whitecatboard/whitecat-hardware/ESP32N1 DEVKIT/Kicad/production/preview.png

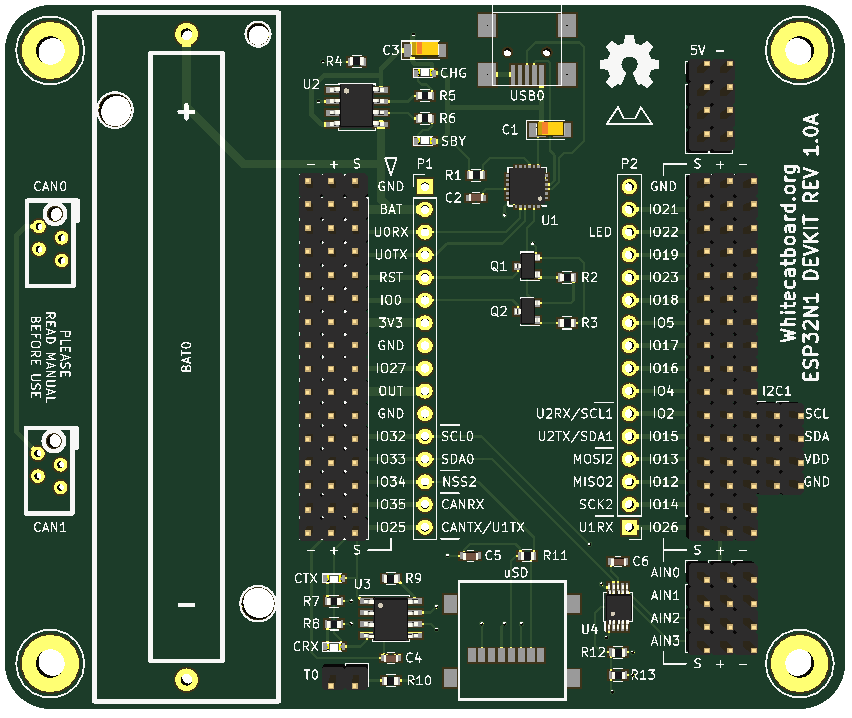
ESP32N1 DEVKIT/Kicad/production/preview.png
