whitecatboard/whitecat-hardware/ESP32N1/Kicad/ESP32N1.pdf

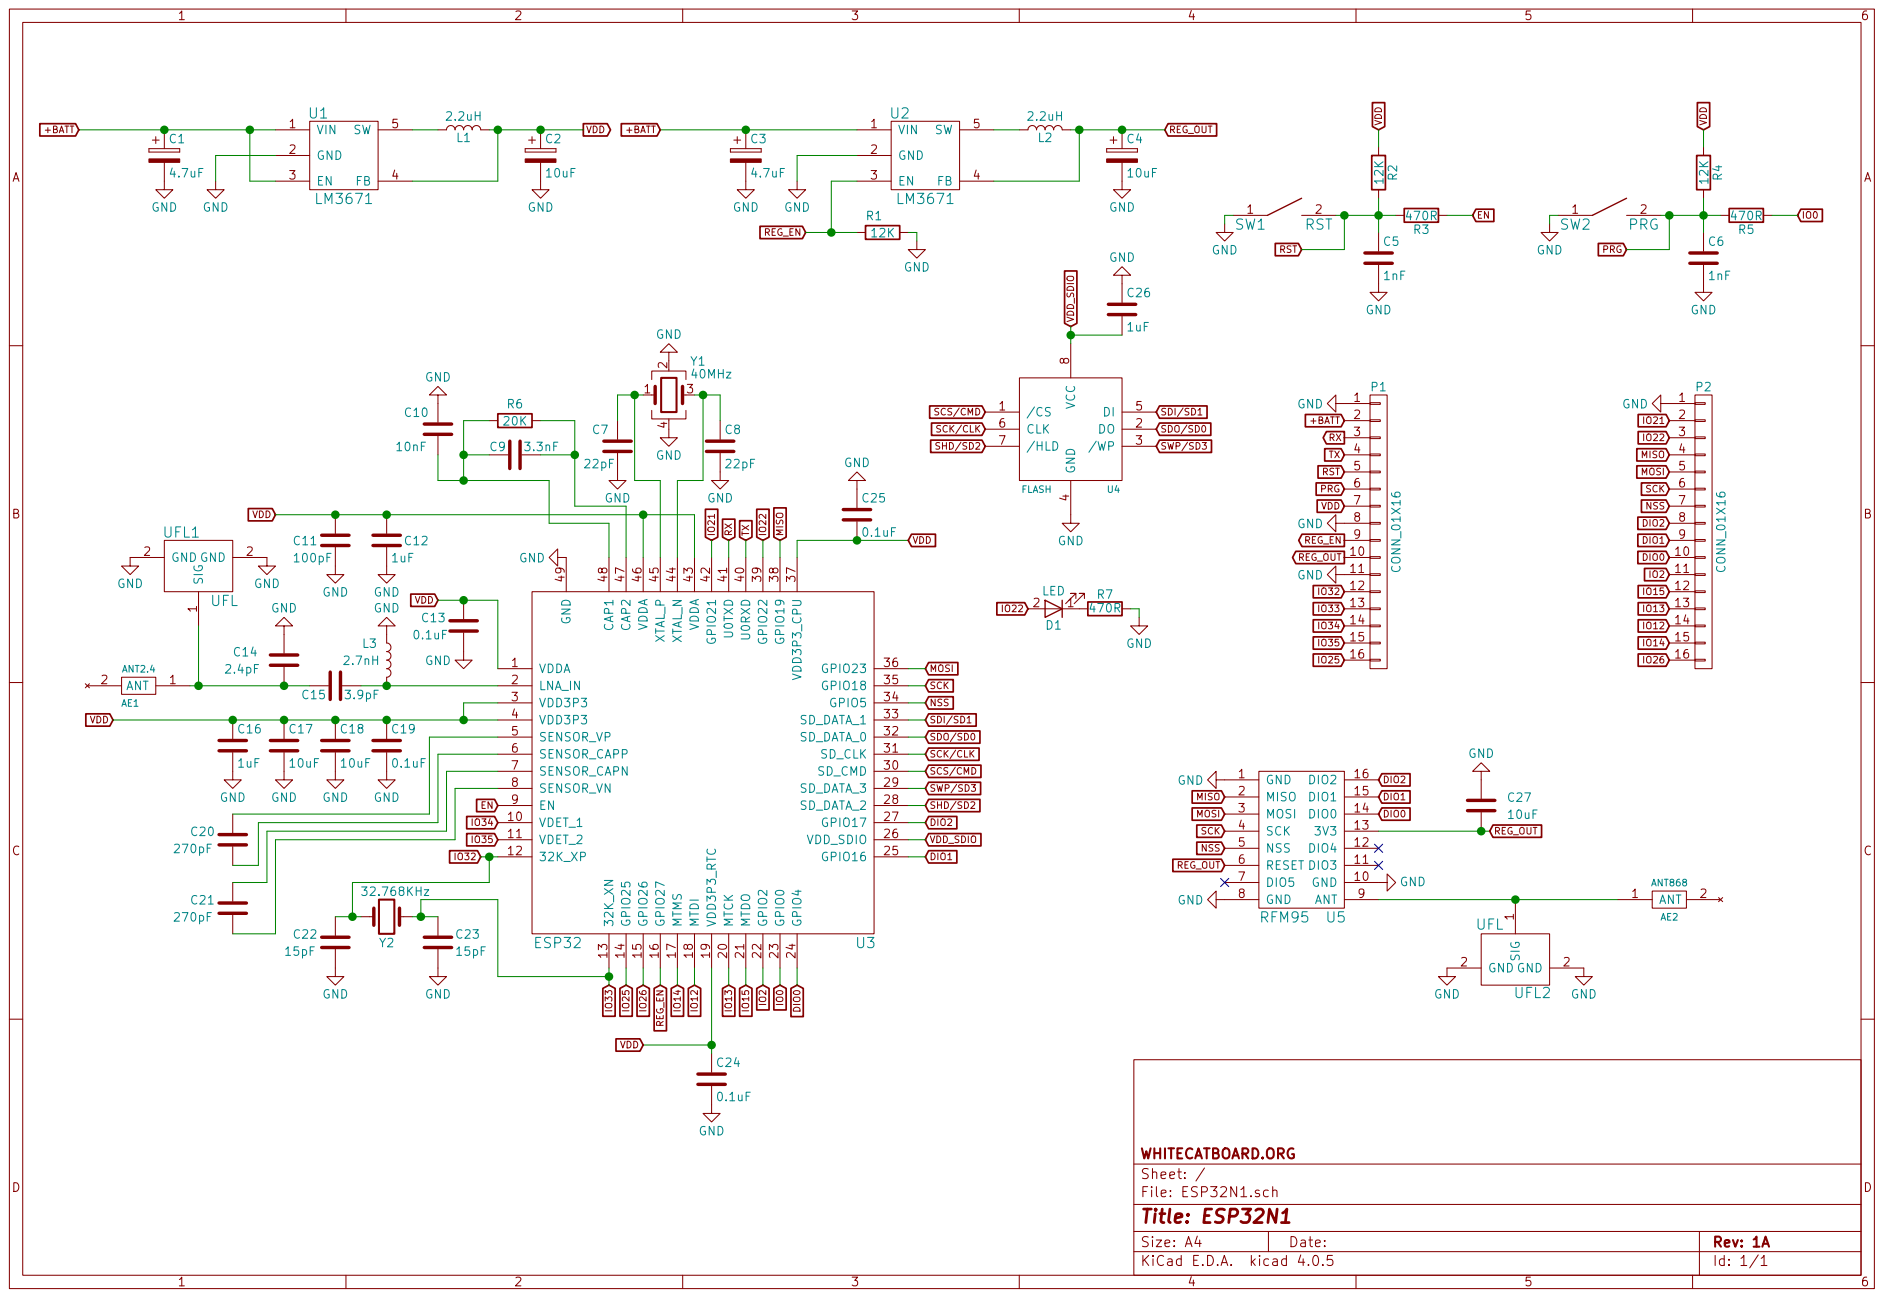
[picture p2: page 1]

IO2 DIO0 DIO1 DIO2 SHD/SD2 SWP/SD3 SCS/CMD

1 GND 2 GND 2 UFL1 UFL GND GND

1 GND 2 GND 2 UFL2 UFL GND GND

File: ESP32N1.sch Sheet: / WHITECATBOARD.ORG
