whitecatboard/whitecat-hardware/ESP32N1/Kicad/ESP32N1.kicad_pcb

## KiCad design ESP32N1/Kicad/ESP32N1.kicad_pcb (2017-11-29)

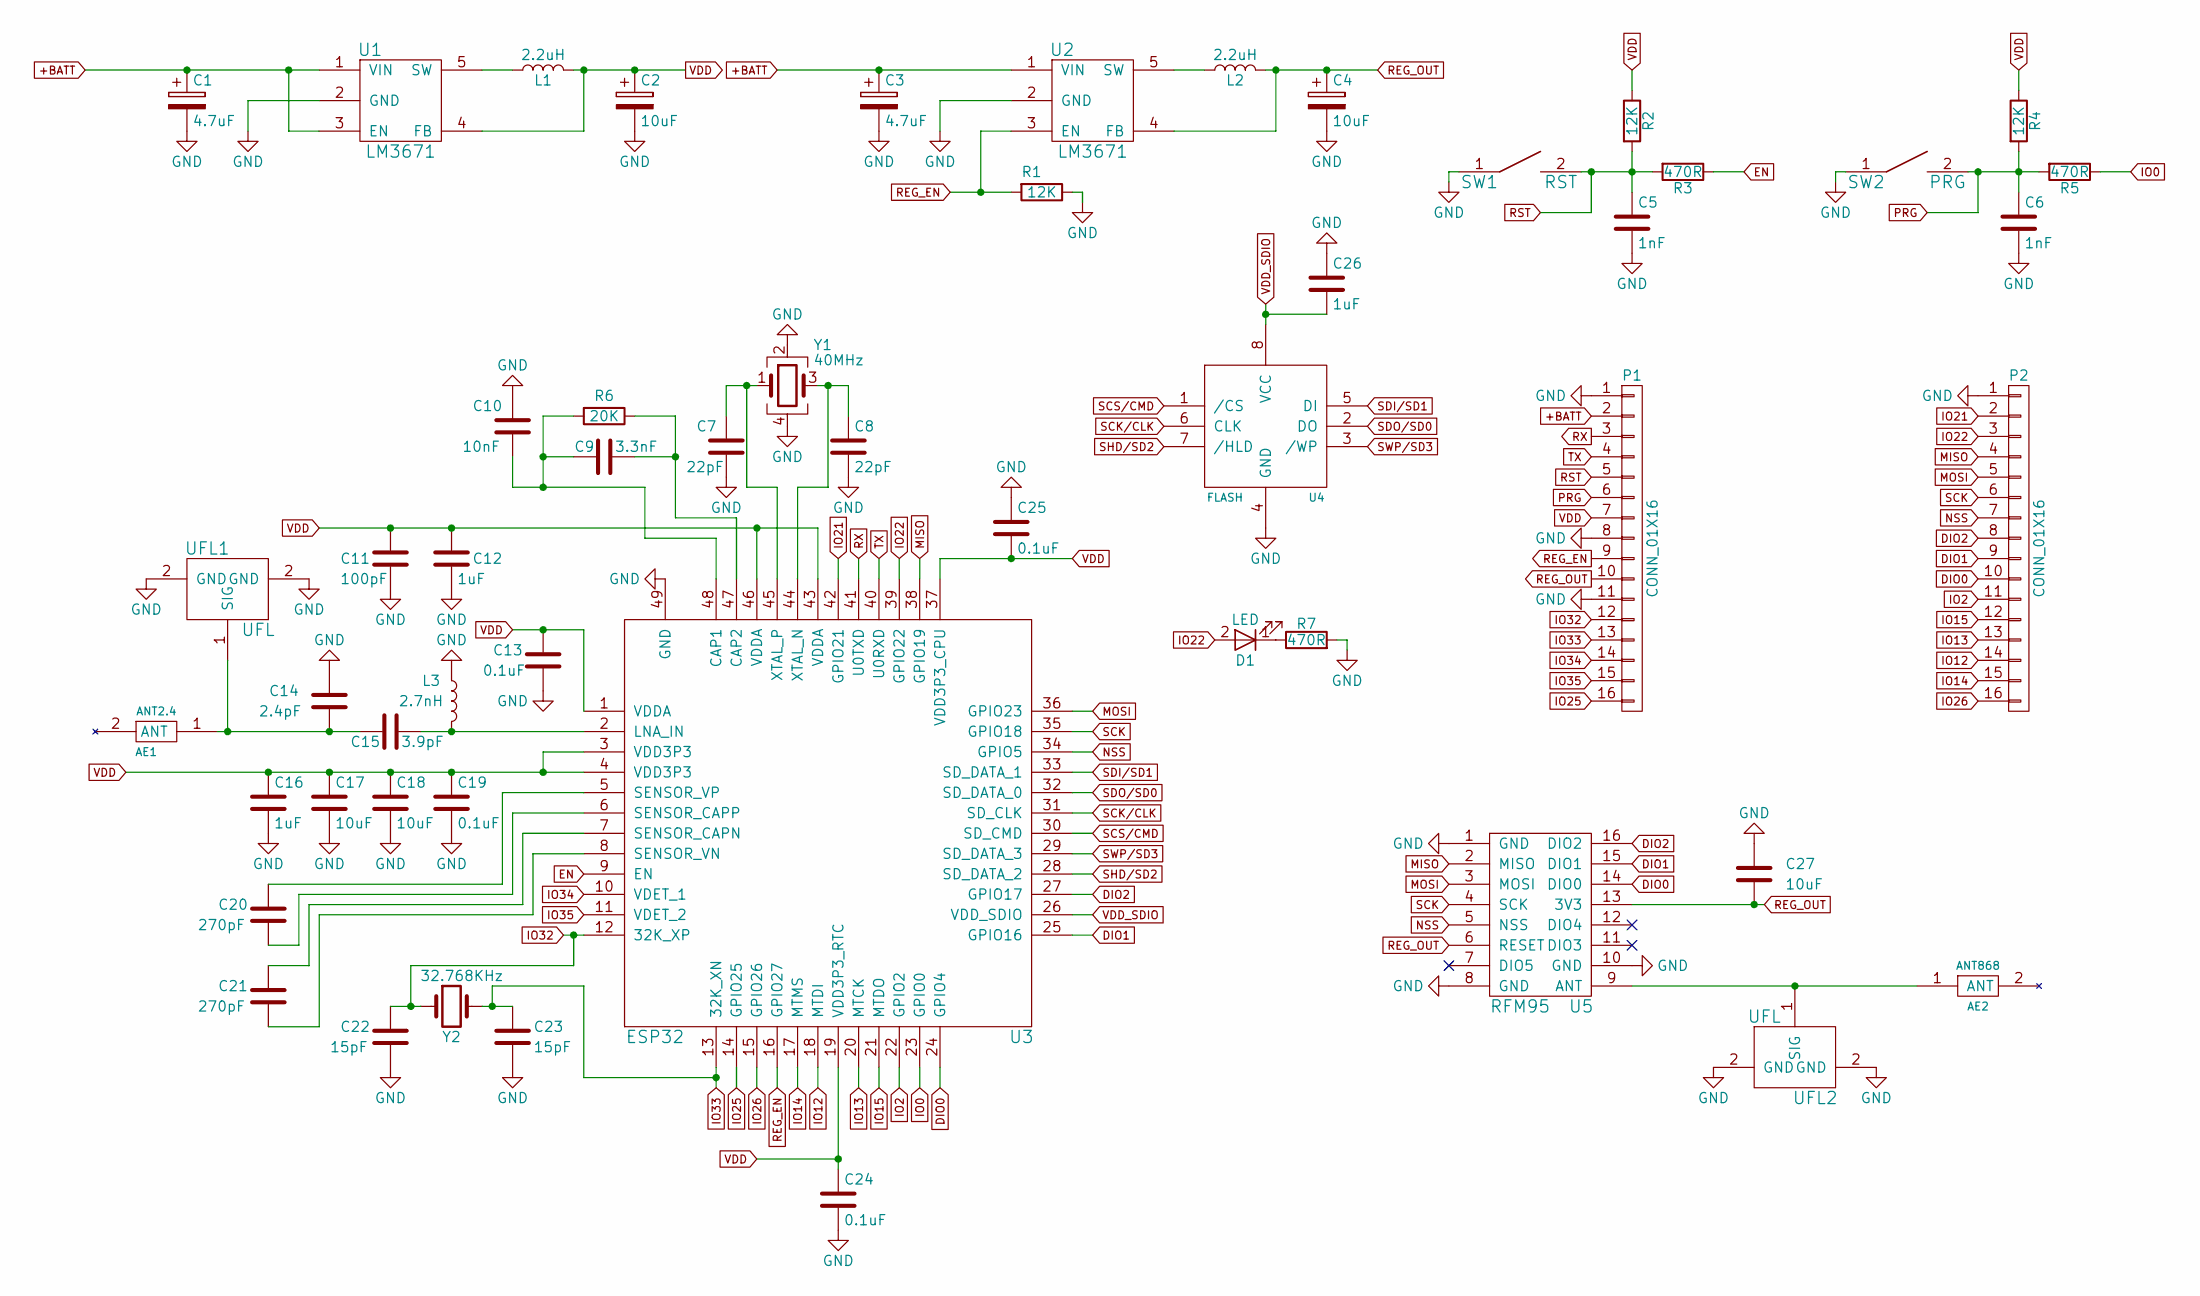
[picture p3: schematic ESP32N1.sch]

Parts:
AE1: ANT2.4
AE2: ANT868
C1, C3: 4.7uF; CP_Tantalum_Case-A_EIA-3216-18_Reflow
C2, C4: 10uF; CP_Tantalum_Case-A_EIA-3216-18_Reflow
C5, C6: 1nF; C_0603
C7, C8: 22pF; C_0603
C9: 3.3nF; C_0603
C10: 10nF; C_0603
C11: 100pF; C_0603
C12, C16, C26: 1uF; C_0603
C13, C19, C24, C25: 0.1uF; C_0603
C14: 2.4pF; C_0603
C15: 3.9pF; C_0603
C17, C18, C27: 10uF; C_0603
C20, C21: 270pF; C_0603
C22, C23: 15pF; C_0603
D1: LED; LED_0603
L1, L2: 2.2uH; R_0603
L3: 2.7nH; R_0603
P1, P2: CONN_01X16; Pin_Header_Straight_1x16_Pitch2.54mm
R1, R2, R4: 12K; R_0603
R3, R5, R7: 470R; R_0603
R6: 20K; R_0603
SW1: RST; PTS820
SW2: PRG; PTS820
U1, U2: LM3671; SOT-23-5
U3: ESP32; UQFN-48-1EP_6x6mm_Pitch0.4mm
U4: FLASH; SOIC-8-208
U5: RFM95; RFM95W
UFL1, UFL2: UFL; COAXIAL_U.FL-R-SMT-1
Y1: 40MHz; Crystal_SMD_TXC_7M-4pin_3.2x2.5mm
Y2: 32.768KHz; Crystal_SMD_MicroCrystal_CC7V-T1A-2pin_3.2x1.5mm

Connections:
+BATT: C1.1, C3.1, P1.2, U1.1 (VIN), U1.3 (EN), U2.1 (VIN)
DIO0: P2.10, U3.24 (GPIO4), U5.14 (DIO0)
DIO1: P2.9, U3.25 (GPIO16), U5.15 (DIO1)
DIO2: P2.8, U3.27 (GPIO17), U5.16 (DIO2)
EN: R3.1, U3.9 (EN)
GND: C1.2, C2.2, C3.2, C4.2, C5.2, C6.2, C7.2, C8.2, C10.1, C11.2, C12.2, C13.2, C14.1, C16.2, C17.2, C18.2, C19.2, C22.2, C23.2, C24.2, C25.1, C26.1, C27.1, L3.1, P1.1, P1.8, P1.11, P2.1, R1.1, R7.2, SW1.1, SW2.1, U1.2 (GND), U2.2 (GND), U3.49 (GND), U4.4 (GND), U5.1 (GND), U5.8 (GND), U5.10 (GND), UFL1.2 (GND), UFL2.2 (GND), Y1.2, Y1.4
IO0: R5.1, U3.23 (GPIO0)
IO2: P2.11, U3.22 (GPIO2)
IO12: P2.14, U3.18 (MTDI)
IO13: P2.13, U3.20 (MTCK)
IO14: P2.15, U3.17 (MTMS)
IO15: P2.12, U3.21 (MTDO)
IO21: P2.2, U3.42 (GPIO21)
IO22: D1.2 (A), P2.3, U3.39 (GPIO22)
IO25: P1.16, U3.14 (GPIO25)
IO26: P2.16, U3.15 (GPIO26)
IO32: C22.1, P1.12, U3.12 (32K_XP), Y2.1
IO33: C23.1, P1.13, U3.13 (32K_XN), Y2.2
IO34: P1.14, U3.10 (VDET_1)
IO35: P1.15, U3.11 (VDET_2)
MISO: P2.4, U3.38 (GPIO19), U5.2 (MISO)
MOSI: P2.5, U3.36 (GPIO23), U5.3 (MOSI)
NSS: P2.7, U3.34 (GPIO5), U5.5 (NSS)
unnamed: AE1.1 (ANT), C14.2, C15.2, UFL1.1 (SIG)
unnamed: AE2.1 (ANT), U5.9 (ANT), UFL2.1 (SIG)
unnamed: C7.1, U3.45 (XTAL_P), Y1.1
unnamed: C8.1, U3.44 (XTAL_N), Y1.3
unnamed: C9.1, R6.1, U3.47 (CAP2)
unnamed: C9.2, C10.2, R6.2, U3.48 (CAP1)
unnamed: C15.1, L3.2, U3.2 (LNA_IN)
unnamed: C20.1, U3.5 (SENSOR_VP)
unnamed: C20.2, U3.6 (SENSOR_CAPP)
unnamed: C21.1, U3.7 (SENSOR_CAPN)
unnamed: C21.2, U3.8 (SENSOR_VN)
unnamed: D1.1 (K), R7.1
unnamed: L1.1, U1.5 (SW)
unnamed: L2.1, U2.5 (SW)
PRG: C6.1, P1.6, R4.2, R5.2, SW2.2
REG_EN: P1.9, R1.2, U2.3 (EN), U3.16 (GPIO27)
REG_OUT: C4.1, C27.2, L2.2, P1.10, U2.4 (FB), U5.6 (RESET), U5.13 (3V3)
RST: C5.1, P1.5, R2.2, R3.2, SW1.2
RX: P1.3, U3.41 (U0TXD)
SCK: P2.6, U3.35 (GPIO18), U5.4 (SCK)
SCK/CLK: U3.31 (SD_CLK), U4.6 (CLK)
SCS/CMD: U3.30 (SD_CMD), U4.1 (/CS)
SDI/SD1: U3.33 (SD_DATA_1), U4.5 (DI)
SDO/SD0: U3.32 (SD_DATA_0), U4.2 (DO)
SHD/SD2: U3.28 (SD_DATA_2), U4.7 (/HLD)
SWP/SD3: U3.29 (SD_DATA_3), U4.3 (/WP)
TX: P1.4, U3.40 (U0RXD)
VDD: C2.1, C11.1, C12.1, C13.1, C16.1, C17.1, C18.1, C19.1, C24.1, C25.2, L1.2, P1.7, R2.1, R4.1, U1.4 (FB), U3.1 (VDDA), U3.3 (VDD3P3), U3.4 (VDD3P3), U3.19 (VDD3P3_RTC), U3.37 (VDD3P3_CPU), U3.43 (VDDA), U3.46 (VDDA)
VDD_SDIO: C26.2, U3.26 (VDD_SDIO), U4.8 (VCC)

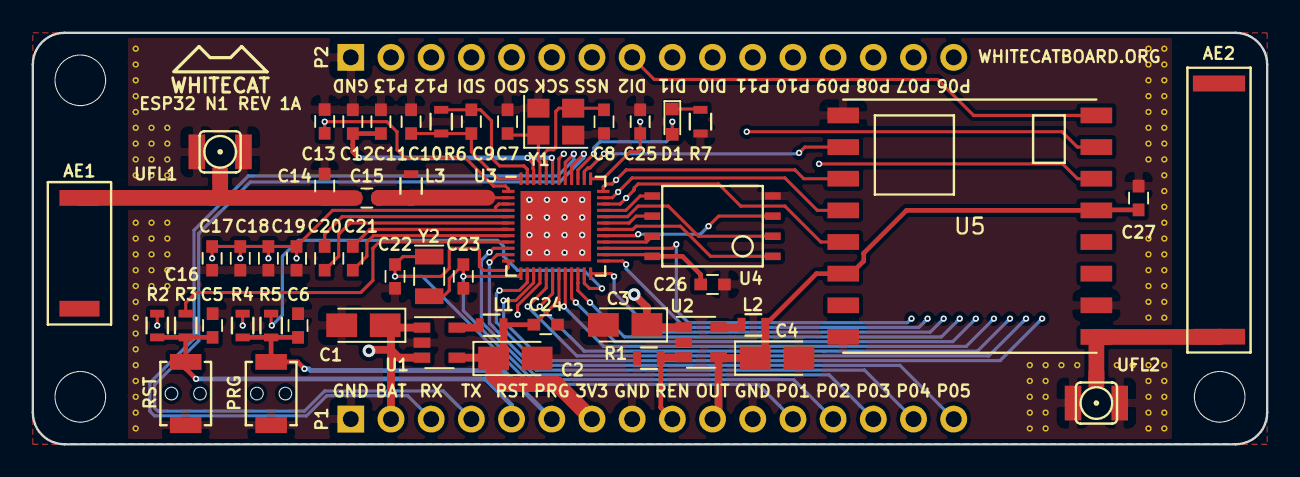
[picture p4: board ESP32N1.kicad_pcb from above]

Board: 4 copper layers, 78.0 x 26.0 mm, 53 parts (0 on the bottom side), 52 nets.
