whitecatboard/whitecat-hardware/ESP32N1 DEVKIT/Kicad/ESP32N1DEVKIT.kicad_pcb

## KiCad design ESP32N1 DEVKIT/Kicad/ESP32N1DEVKIT.kicad_pcb (2017-11-29)

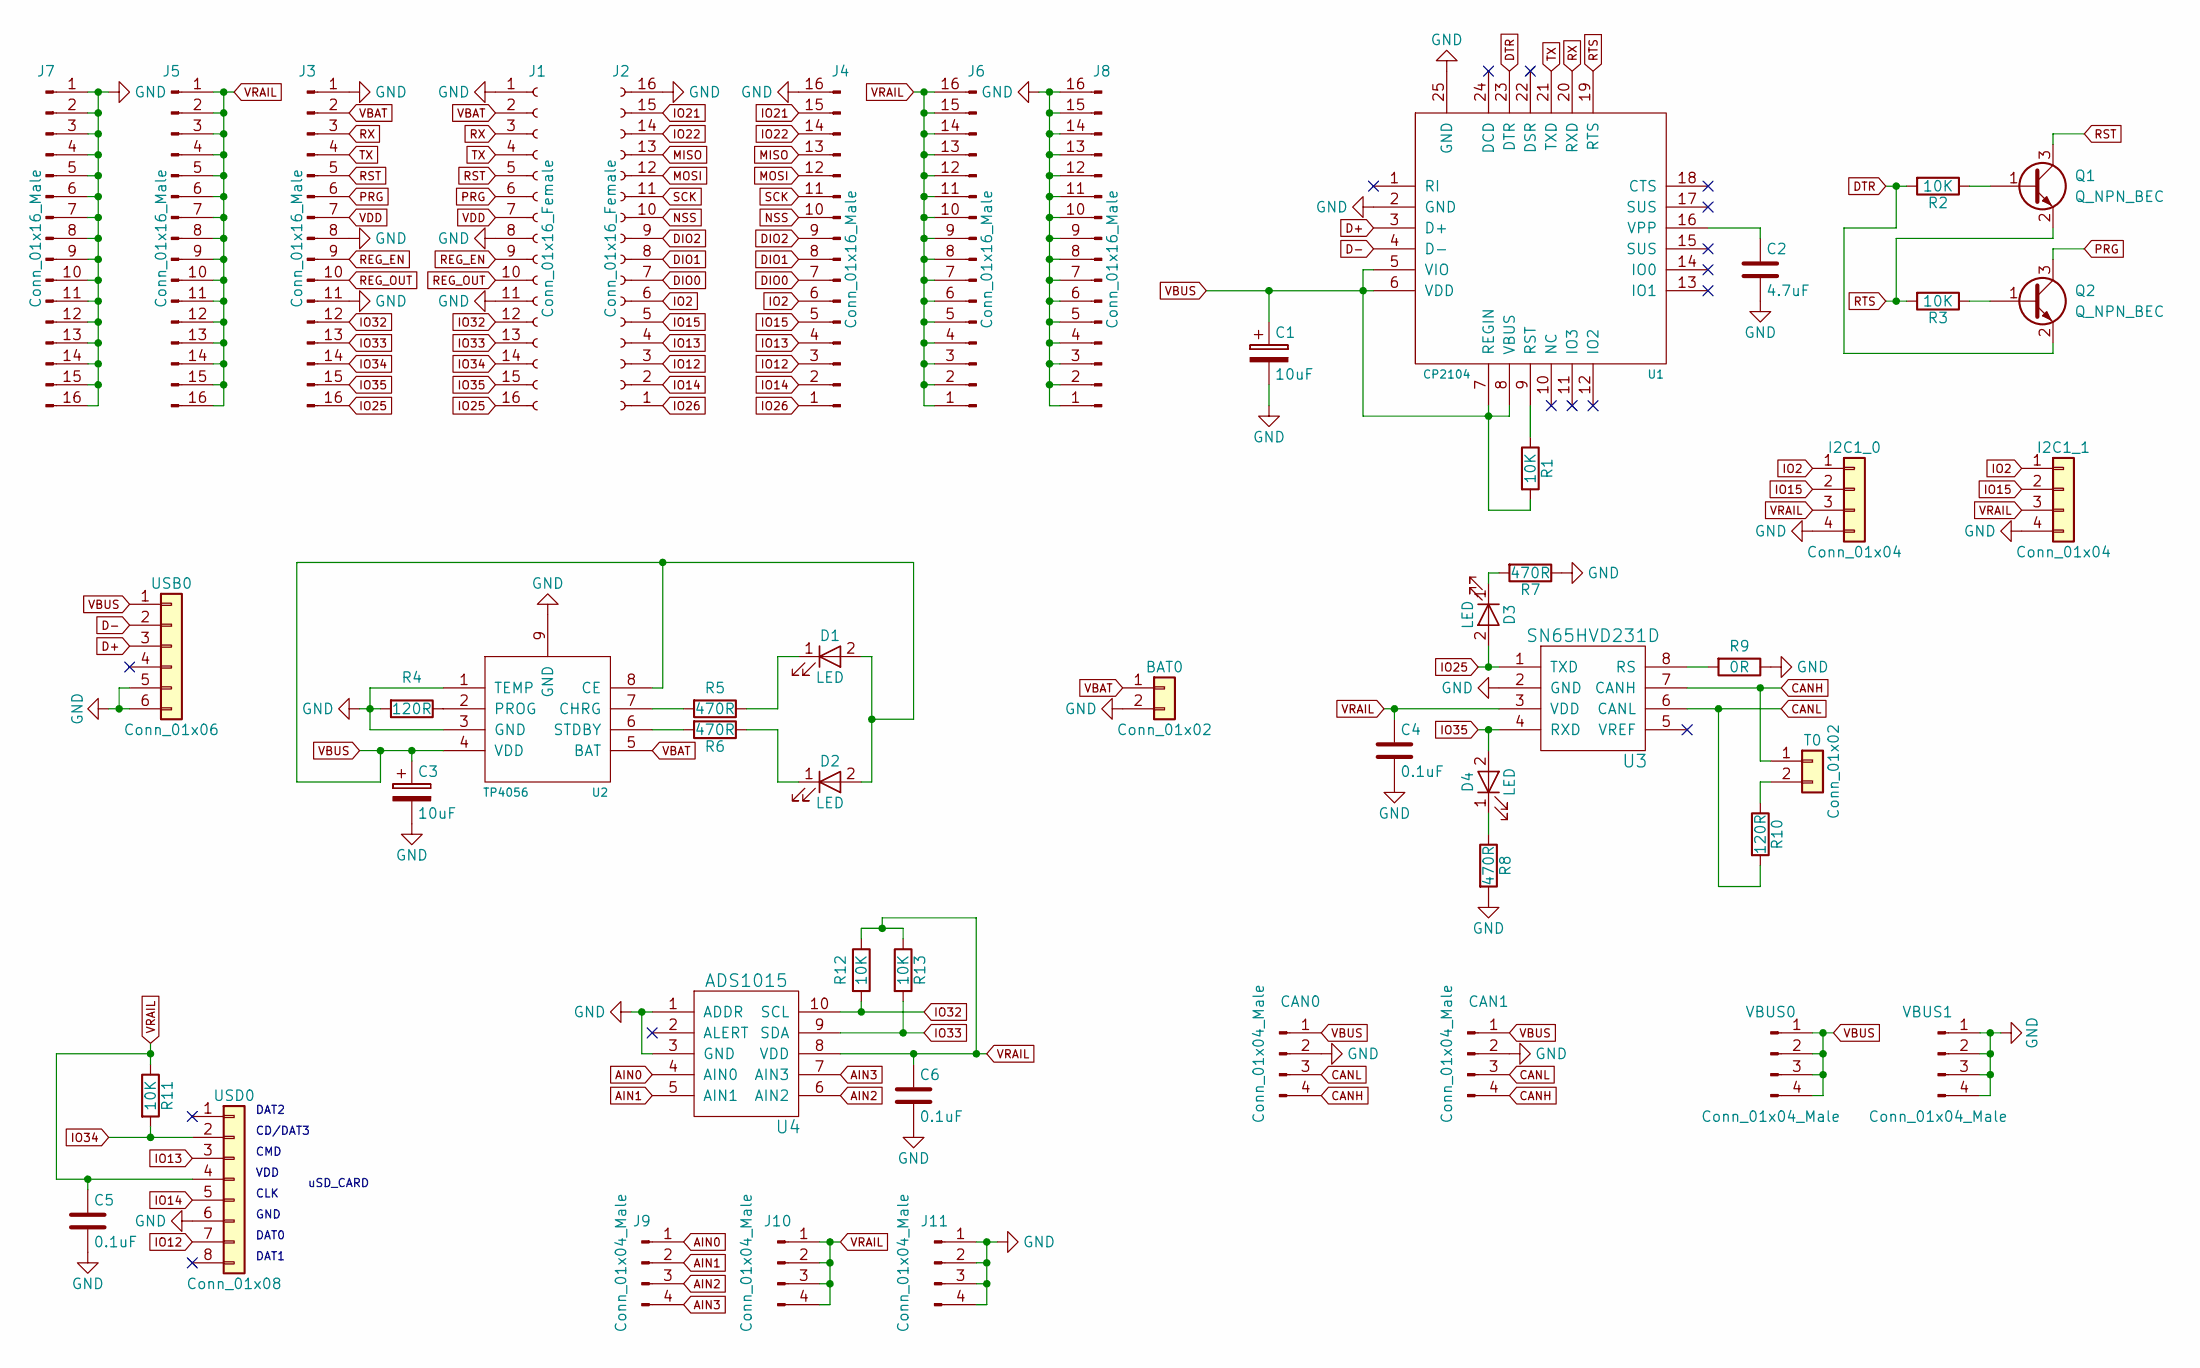
[picture p5: schematic ESP32N1DEVKIT.sch]

Parts:
BAT0: Conn_01x02; 18650_holder
C1, C3: 10uF; CP_Tantalum_Case-A_EIA-3216-18_Reflow
C2: 4.7uF; C_0603
C4, C5, C6: 0.1uF; C_0603
CAN0, CAN1: Conn_01x04_Male; micro_match_4p
D1, D2, D3, D4: LED; LED_0603
I2C1_0, I2C1_1: Conn_01x04; Pin_Header_Straight_1x04_Pitch2.54mm
J1, J2: Conn_01x16_Female; Pin_Header_Straight_1x16_Pitch2.54mm
J3, J4, J5, J6, J7, J8: Conn_01x16_Male; Pin_Header_Straight_1x16_Pitch2.54mm
J9, J10, J11: Conn_01x04_Male; Pin_Header_Straight_1x04_Pitch2.54mm
Q1, Q2: Q_NPN_BEC; SOT-23
R1, R2, R3, R11, R12, R13: 10K; R_0603
R4, R10: 120R; R_0603
R5, R6, R7, R8: 470R; R_0603
R9: 0R; R_0603
T0: Conn_01x02; Pin_Header_Straight_1x02_Pitch2.54mm
U1: CP2104; QFN-24-1EP_4x4mm_Pitch0.5mm
U2: TP4056; SOIC-8-1EP_3.9x4.9mm_Pitch1.27mm
U3: SN65HVD231D; SOIC-8_3.9x4.9mm_Pitch1.27mm
U4: ADS1015; TSSOP-10_3x3mm_Pitch0.5mm
USB0: Conn_01x06; USB_Mini-B
USD0: Conn_01x08; msd_socket
VBUS0, VBUS1: Conn_01x04_Male; Pin_Header_Straight_1x04_Pitch2.54mm

Connections:
AIN0: J9.1, U4.4 (AIN0)
AIN1: J9.2, U4.5 (AIN1)
AIN2: J9.3, U4.6 (AIN2)
AIN3: J9.4, U4.7 (AIN3)
CANH: CAN0.4, CAN1.4, T0.1, U3.7 (CANH)
CANL: CAN0.3, CAN1.3, R10.2, U3.6 (CANL)
D+: U1.3 (D+), USB0.3
D-: U1.4 (D-), USB0.2
DIO0: J2.7, J4.7
DIO1: J2.8, J4.8
DIO2: J2.9, J4.9
DTR: Q2.2 (E), R2.2, U1.23 (DTR)
GND: BAT0.2, C1.2, C2.2, C3.2, C4.2, C5.2, C6.2, CAN0.2, CAN1.2, I2C1_0.4, I2C1_1.4, J1.1, J1.8, J1.11, J2.16, J3.1, J3.8, J3.11, J4.16, J7.1, J7.2, J7.3, J7.4, J7.5, J7.6, J7.7, J7.8, J7.9, J7.10, J7.11, J7.12, J7.13, J7.14, J7.15, J7.16, J8.1, J8.2, J8.3, J8.4, J8.5, J8.6, J8.7, J8.8, J8.9, J8.10, J8.11, J8.12, J8.13, J8.14, J8.15, J8.16, J11.1, J11.2, J11.3, J11.4, R4.2, R7.1, R8.2, R9.1, U1.2 (GND), U1.25 (GND), U2.1 (TEMP), U2.3 (GND), U2.9 (GND), U3.2 (GND), U4.1 (ADDR), U4.3 (GND), USB0.5, USB0.6, USD0.6, VBUS1.1, VBUS1.2, VBUS1.3, VBUS1.4
IO2: I2C1_0.1, I2C1_1.1, J2.6, J4.6
IO12: J2.3, J4.3, USD0.7
IO13: J2.4, J4.4, USD0.3
IO14: J2.2, J4.2, USD0.5
IO15: I2C1_0.2, I2C1_1.2, J2.5, J4.5
IO21: J2.15, J4.15
IO22: J2.14, J4.14
IO25: D3.2 (A), J1.16, J3.16, U3.1 (TXD)
IO26: J2.1, J4.1
IO32: J1.12, J3.12, R12.2, U4.10 (SCL)
IO33: J1.13, J3.13, R13.2, U4.9 (SDA)
IO34: J1.14, J3.14, R11.2, USD0.2
IO35: D4.2 (A), J1.15, J3.15, U3.4 (RXD)
MISO: J2.13, J4.13
MOSI: J2.12, J4.12
NSS: J2.10, J4.10
unnamed: C2.1, U1.16 (VPP)
unnamed: D1.1 (K), R5.1
unnamed: D2.1 (K), R6.1
unnamed: D3.1 (K), R7.2
unnamed: D4.1 (K), R8.1
unnamed: Q1.1 (B), R2.1
unnamed: Q2.1 (B), R3.1
unnamed: R1.1, U1.9 (RST)
unnamed: R4.1, U2.2 (PROG)
unnamed: R5.2, U2.7 (CHRG)
unnamed: R6.2, U2.6 (STDBY)
unnamed: R9.2, U3.8 (RS)
unnamed: R10.1, T0.2
PRG: J1.6, J3.6, Q2.3 (C)
REG_EN: J1.9, J3.9
REG_OUT: J1.10, J3.10
RST: J1.5, J3.5, Q1.3 (C)
RTS: Q1.2 (E), R3.2, U1.19 (RTS)
RX: J1.3, J3.3, U1.20 (RXD)
SCK: J2.11, J4.11
TX: J1.4, J3.4, U1.21 (TXD)
VBAT: BAT0.1, J1.2, J3.2, U2.5 (BAT)
VBUS: C1.1, C3.1, CAN0.1, CAN1.1, D1.2 (A), D2.2 (A), R1.2, U1.5 (VIO), U1.6 (VDD), U1.7 (REGIN), U1.8 (VBUS), U2.4 (VDD), U2.8 (CE), USB0.1, VBUS0.1, VBUS0.2, VBUS0.3, VBUS0.4
VDD: J1.7, J3.7
VRAIL: C4.1, C5.1, C6.1, I2C1_0.3, I2C1_1.3, J5.1, J5.2, J5.3, J5.4, J5.5, J5.6, J5.7, J5.8, J5.9, J5.10, J5.11, J5.12, J5.13, J5.14, J5.15, J5.16, J6.1, J6.2, J6.3, J6.4, J6.5, J6.6, J6.7, J6.8, J6.9, J6.10, J6.11, J6.12, J6.13, J6.14, J6.15, J6.16, J10.1, J10.2, J10.3, J10.4, R11.1, R12.1, R13.1, U3.3 (VDD), U4.8 (VDD), USD0.4

Notes on the sheet:
DAT2
CD/DAT3
CMD
VDD
CLK
GND
DAT0
DAT1
uSD_CARD

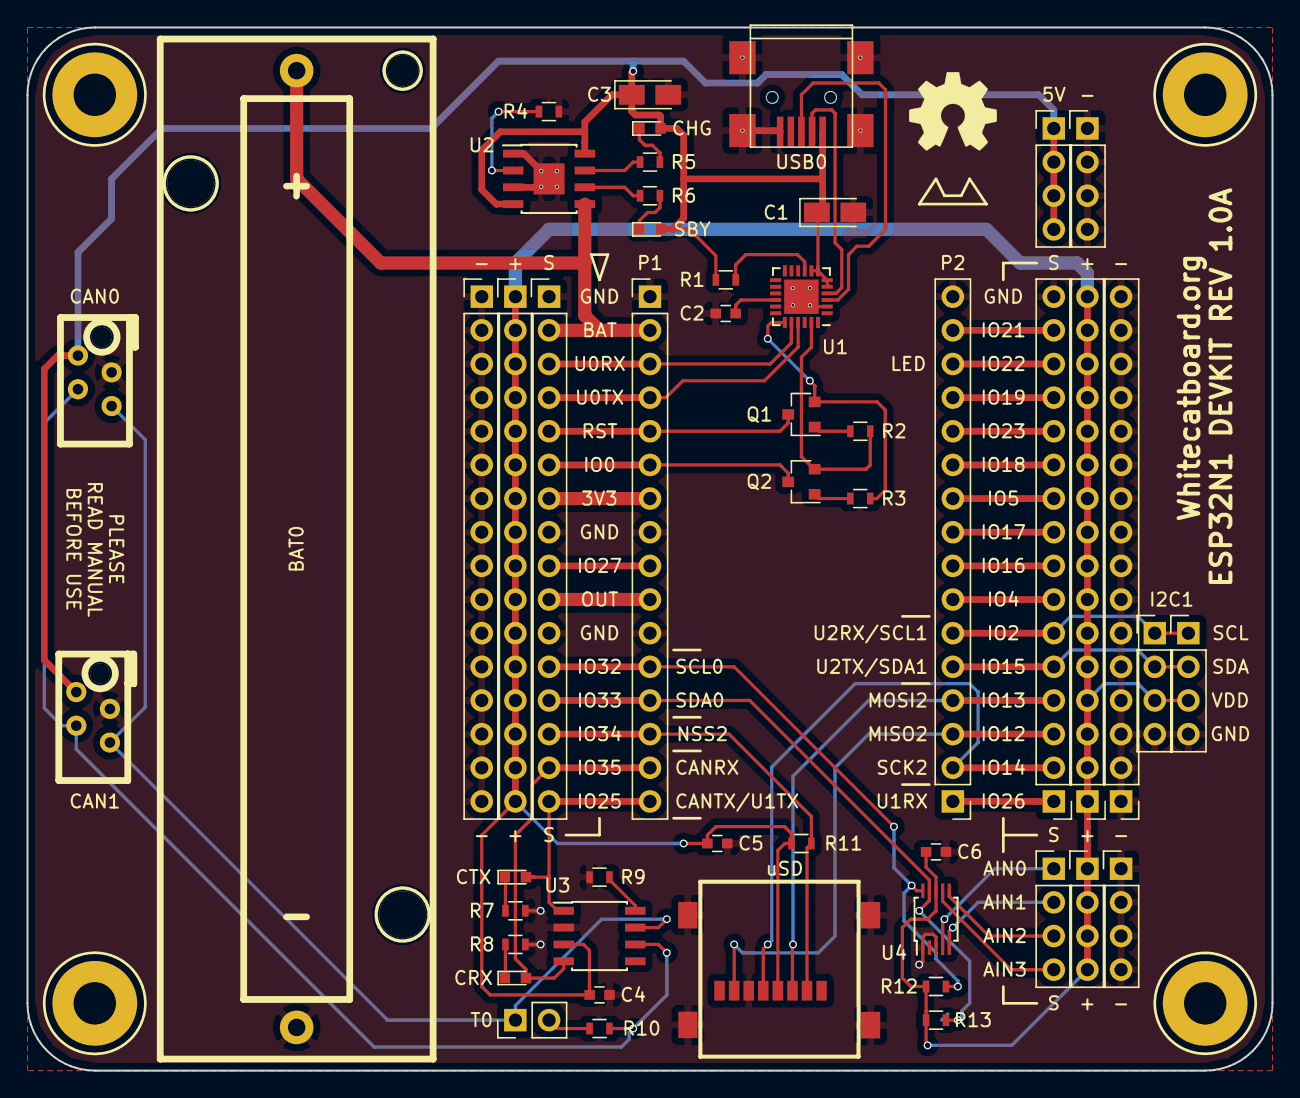
[picture p6: board ESP32N1DEVKIT.kicad_pcb from above]

Board: 2 copper layers, 94.0 x 78.7 mm, 50 parts (0 on the bottom side), 54 nets.
