whitecatboard/whitecat-hardware/(commit log)

2017-11-29 Added Kicad files for ESP32N1 DEVKIT board
    [ESP32N1DEVKIT-B.Cu.gbr, ESP32N1DEVKIT-B.Mask.gbr, ESP32N1DEVKIT-Edge.Cuts.gbr, ESP32N1DEVKIT-F.Cu.gbr, ESP32N1DEVKIT-F.Mask.gbr, ESP32N1DEVKIT-F.Paste.gbr, ESP32N1DEVKIT-F.SilkS.gbr, ESP32N1DEVKIT-NPTH.drl]
2017-11-29 Added Kicad files for ESP32N1 board
    [ESP32N1-B.Cu.gbr, ESP32N1-B.Mask.gbr, ESP32N1-Edge.Cuts.gbr, ESP32N1-F.Cu.gbr, ESP32N1-F.Mask.gbr, ESP32N1-F.Paste.gbr, ESP32N1-F.SilkS.gbr, ESP32N1-In1.Cu.gbr]
2017-12-11 Added ESP32N1 DEVKI manual (spanish)
